kurrosetra/RCWS/Documents/Wiring pinout.xlsx

Sheet: BUTTON
from BATTERY
A | +24V BATT IN
B | +24V BATT IN
C | GND BATT IN
D | GND BATT IN
to PANEL
A | +24V OUT
B | +24V OUT
C | +24V OUT
D | GND OUT
E | GND OUT
F | GND OUT
G | COMM Out (Serial Tx)

Sheet: PANEL
from BUTTON |  | to Motor Driver
A | +24V IN | A | +24V OUT
B | +24V IN | B | +24V OUT
C | +24V IN | C | CAN High
D | GND IN | D | CAN Low
E | GND IN | E | Video+
F | GND IN | F | Video-
G | COMM In (Serial Rx) | G | +24V OUT
 |  | H | GND OUT
to Monitor & Joystick |  | I | GND OUT
1 | - | J | GND OUT
2 | - | K | +24V OUT
3 | - | L | -
4 | - | M | -
5 | - | N | GND OUT
6 | +24V OUT
7 | CAN HIGH (Joystick)
8 | CAN LOW (Joystick)
9 | GND OUT

Sheet: SLIP RING
Slip Ring |  | Panel | Motor Driver
Besar | Merah | A
 | Hitam | J
 | Hijau | B
 | Kuning | I
Kecil 1 | Merah | K
 | Hitam | N
 | Hijau | C
 | Kuning | D
 | Biru | G
 | Putih | H
Kecil 2 | Merah | -
 | Hitam | -
 | Hijau | -
 | Kuning | -
 | Biru | F
 | Putih | E
Kecil (lepas) | Merah | K
 | Hitam | N

Sheet: MOTOR_DRIVER
from Panel |  | to Optronik
A | +24V PAN | A | +24V Out
B | +24V TILT | B | GND Out
C | CAN High | C | CAN High
D | CAN Low | D | CAN Low
E | Video+ | E | Video +
F | Video- | F | Video -
G | +24V In | G | IMU Tx
H | GND In
I | GND TILT | to Trigger
J | GND PAN | 1 | TRIGGER 1
K | +24V In | 2 | TRIGGER 1
L | - | 3 | TRIGGER 1
M | - | 4 | TRIGGER 2
N | GND In | 5 | TRIGGER 2
 |  | 6 | TRIGGER 2

Sheet: OPTRONIK
to Optronik
A | +24V Out
B | GND Out
C | CAN High
D | CAN Low
E | Video +
F | Video -
G | IMU Tx

Sheet: PANEL-old
from BUTTON |  | to Motor Driver
A | +24V IN | A | +24V OUT
B | +24V IN | B | +24V OUT
C | +24V IN | C | Tx_A_Out
D | GND IN | D | Tx_B_Out
E | GND IN | E | Video+
F | GND IN | F | Video-
G | COMM In (Serial Rx) | G | Rx_A_In
 |  | H | Rx_B_In
to Monitor & Joystick |  | I | GND OUT
A | +12V OUT (Monitor) | J | GND OUT
B | +12V OUT (Joystick) | K | +24V OUT
C | CAN LOW (Joystick) | L | -
D | GND OUT (Monitor) | M | -
E | CAN HIGH (Joystick) | N | GND OUT
F | GND OUT (Joystick)
G | -

Sheet: MOTOR_DRIVER-old
from Panel |  | to Optronik
A | +24V PAN | A | +24V Out
B | +24V TILT | B | GND Out
C | Tx_A_Out | C | CAN High
D | Tx_B_Out | D | CAN Low
E | Video+ | E | Video +
F | Video- | F | Video -
G | Rx_A_In | G | IMU Tx
H | Rx_B_In
I | GND TILT | to Trigger
J | GND PAN | 1 | Motor OUT 4
K | +24V In | 2 | Motor OUT 3
L | - | 3 | -
M | - | 4 | Motor OUT 2
N | GND In | 5 | Motor OUT 1
