kurrosetra/RCWS/(list of files, drawings)

Other design files:
Boards/Optronik/optronik.PcbDoc
