kurrosetra/RCWS/Boards/Panel/panel.brd

## EAGLE design Boards/Panel/panel.brd (2018-04-27)

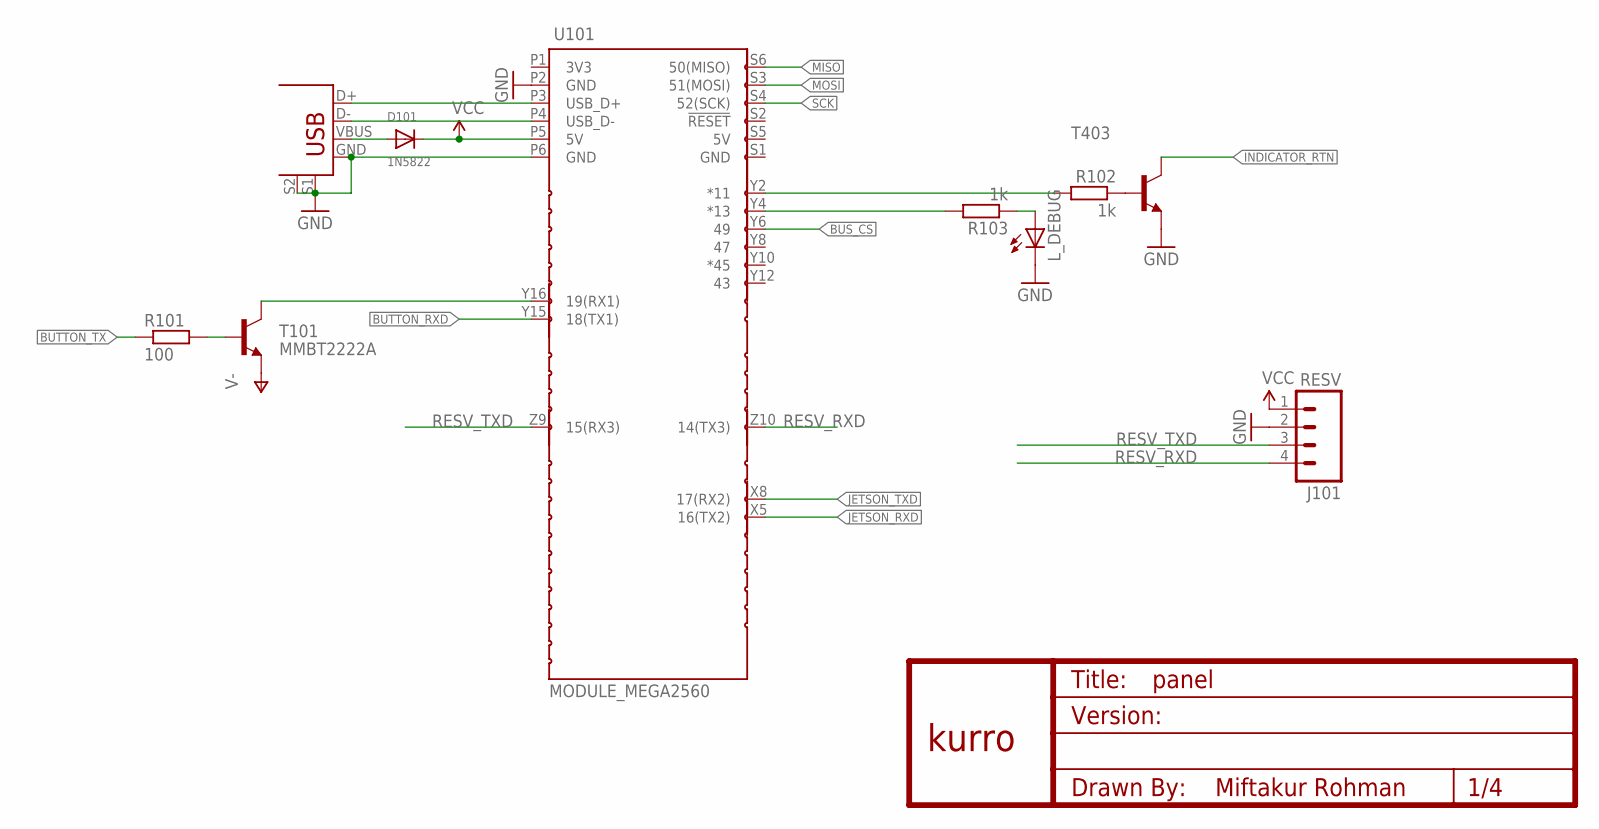
[picture p1: schematic panel.sch, sheet 1, MAIN]

Parts:
D101: 1N5822; SMADIODE
J101: RESV; XH-4-RA
L_DEBUG: LED5MM
R101: 100; R0603
R102, R103: 1k; R0603
T101: MMBT2222A; SOT23
T403: MMBT2222ALT1-NPN-SOT23-BEC; SOT23-BEC
U101: MODULE_MEGA2560; MOD_MEGA_LAYOUT
U$1: KURRO_FOOTPRINT; KURRO-LOGO
U$2: USB+SHIELD; USB-B-PTH
U$3: MOD_MEGA_LAYOUT_SERIAL1
U$4: MOD_MEGA_LAYOUT_SERIAL2
U$5: MOD_MEGA_LAYOUT_SERIAL3
U$6: MOD_MEGA_LAYOUT_ICSP
U$7: MOD_MEGA_LAYOUT_Y_EVEN

Connections:
BUS_CS: U$7.Y6 (49); also elsewhere on the board
BUTTON_RXD: U$3.Y15 (18(TX1))
BUTTON_TX: R101.1; also elsewhere on the board
BUTTON_TXD: T101.3 (C), U$3.Y16 (19(RX1))
GND: J101.2, L_DEBUG.K (C), T403.E, U101.P2 (GND), U101.P6 (GND), U$2.GND, U$2.S1, U$2.S2; also elsewhere on the board
INDICATOR_RTN: T403.C; also elsewhere on the board
JETSON_RXD: U$4.X5 (16(TX2)); also elsewhere on the board
JETSON_TXD: U$4.X8 (17(RX2)); also elsewhere on the board
MISO: U$6.S6 (50(MISO)); also elsewhere on the board
MOSI: U$6.S3 (51(MOSI)); also elsewhere on the board
unnamed: R102.1, T403.B
unnamed: U101.P3 (USB_D+), U$2.D+
unnamed: U101.P4 (USB_D-), U$2.D-
unnamed: D101.A, U$2.VBUS
unnamed: R102.2, U$7.Y2 (*11)
unnamed: R101.2, T101.1 (B)
unnamed: L_DEBUG.A, R103.1
unnamed: R103.2, U$7.Y4 (*13)
RESV_RXD: J101.4, U$5.Z10 (14(TX3))
RESV_TXD: J101.3, U$5.Z9 (15(RX3))
SCK: U$6.S4 (52(SCK)); also elsewhere on the board
V-: T101.2 (E); also elsewhere on the board
VCC: D101.C, J101.1, U101.P5 (5V); also elsewhere on the board

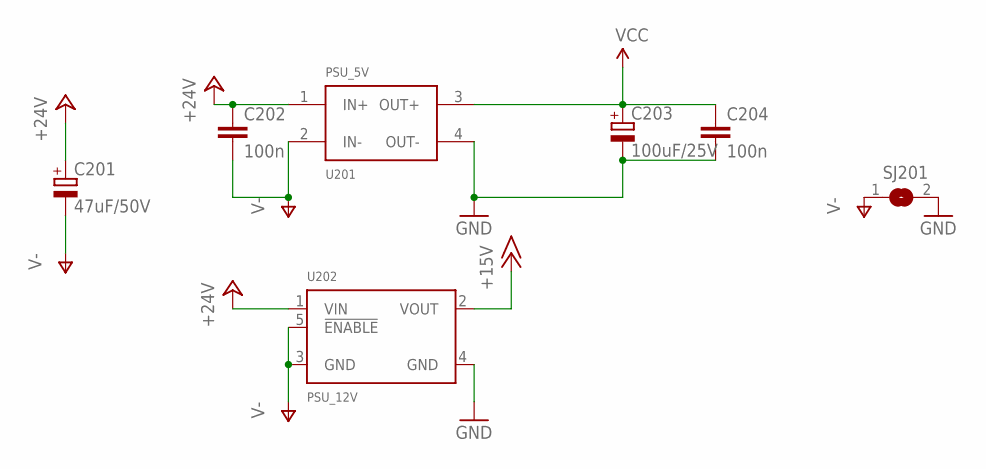
[picture p2: schematic panel.sch, sheet 2, PSU]

Parts:
C201: 47uF/50V; E2,5-7
C202, C204: 100n; C0603
C203: 100uF/25V; E2,5-7
SJ201: SJS
U201: PSU_5V; MP1584_MIN
U202: PSU_12V; MOD_LM2596

Connections:
+15V: U202.2 (VOUT); also elsewhere on the board
+24V: C201.+, C202.1, U201.1 (IN+), U202.1 (VIN); also elsewhere on the board
GND: C203.-, C204.2, SJ201.2, U201.4 (OUT-), U202.4 (GND); also elsewhere on the board
V-: C201.-, C202.2, SJ201.1, U201.2 (IN-), U202.3 (GND), U202.5 (!ENABLE); also elsewhere on the board
VCC: C203.+, C204.1, U201.3 (OUT+); also elsewhere on the board

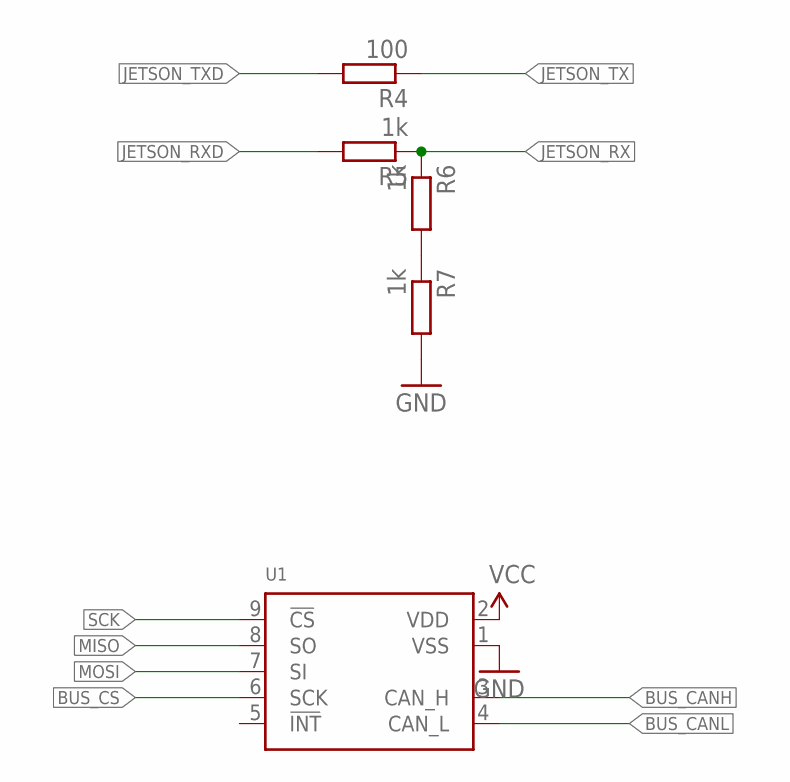
[picture p3: schematic panel.sch, sheet 3, COMM]

Parts:
R4: 100; R0603
R5, R6, R7: 1k; R0603
U1: MOD_MCP2515_NH; MCP2515_CAN2

Connections:
BUS_CANH: U1.3 (CAN_H); also elsewhere on the board
BUS_CANL: U1.4 (CAN_L); also elsewhere on the board
BUS_CS: U1.6 (SCK); also elsewhere on the board
GND: R7.2, U1.1 (VSS); also elsewhere on the board
JETSON_RX: R5.1, R6.1; also elsewhere on the board
JETSON_RXD: R5.2; also elsewhere on the board
JETSON_TX: R4.1; also elsewhere on the board
JETSON_TXD: R4.2; also elsewhere on the board
MISO: U1.8 (SO); also elsewhere on the board
MOSI: U1.7 (SI); also elsewhere on the board
unnamed: R6.2, R7.1
SCK: U1.9 (!CS); also elsewhere on the board
VCC: U1.2 (VDD); also elsewhere on the board

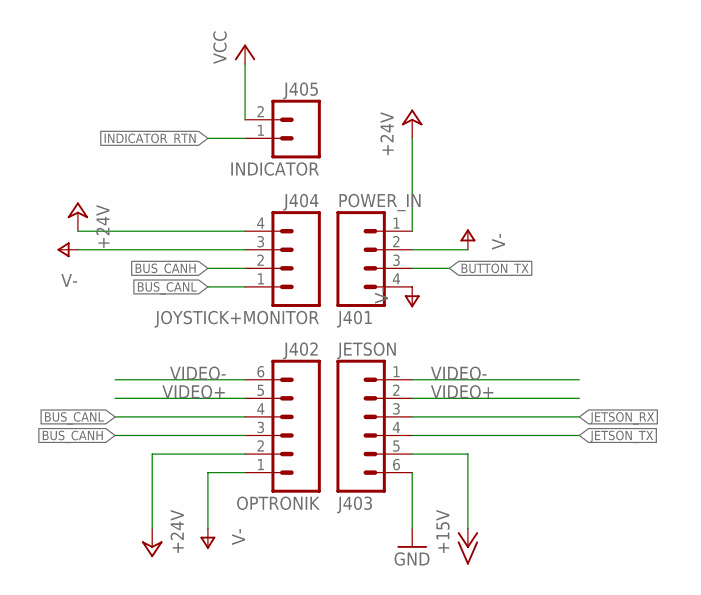
[picture p4: schematic panel.sch, sheet 4, CONNECTOR]

Parts:
J401: POWER_IN; XH-4-RA
J402: OPTRONIK; XH-6-RA
J403: JETSON; XH-6-RA
J404: JOYSTICK+MONITOR; XH-4-RA
J405: INDICATOR; XH-2-RA

Connections:
+15V: J403.5; also elsewhere on the board
+24V: J401.1, J402.2, J404.4; also elsewhere on the board
BUS_CANH: J402.3, J404.2; also elsewhere on the board
BUS_CANL: J402.4, J404.1; also elsewhere on the board
BUTTON_TX: J401.3; also elsewhere on the board
GND: J403.6; also elsewhere on the board
INDICATOR_RTN: J405.1; also elsewhere on the board
JETSON_RX: J403.3; also elsewhere on the board
JETSON_TX: J403.4; also elsewhere on the board
V-: J401.2, J401.4, J402.1, J404.3; also elsewhere on the board
VCC: J405.2; also elsewhere on the board
VIDEO+: J402.5, J403.2
VIDEO-: J402.6, J403.1

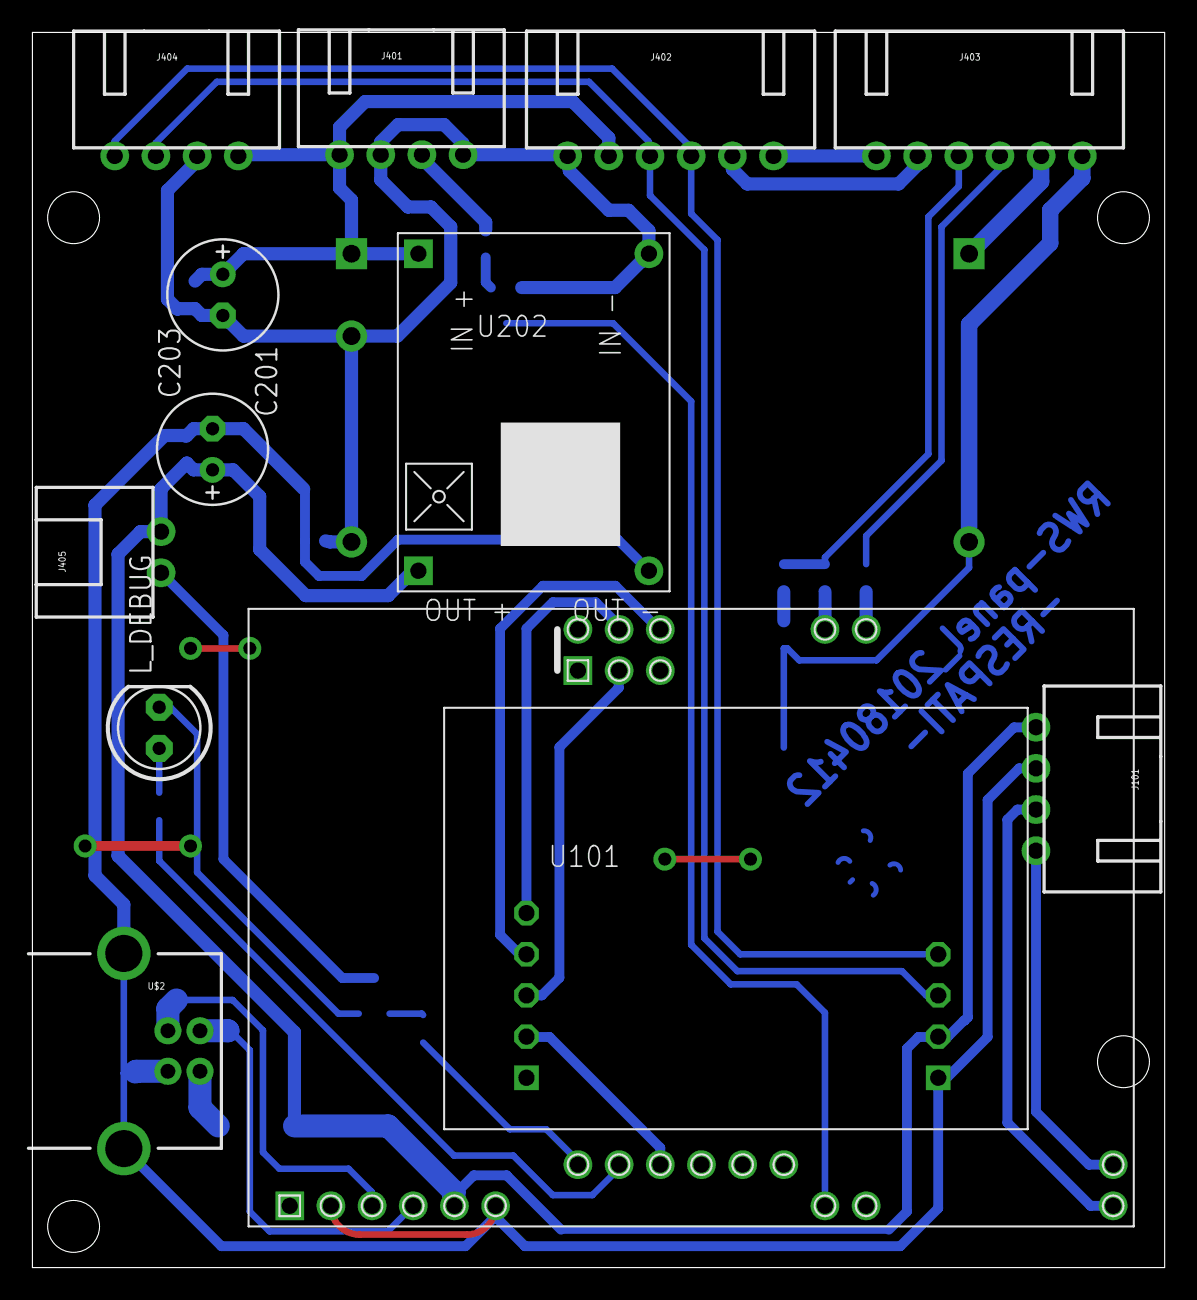
[picture p5: board panel.brd from above]

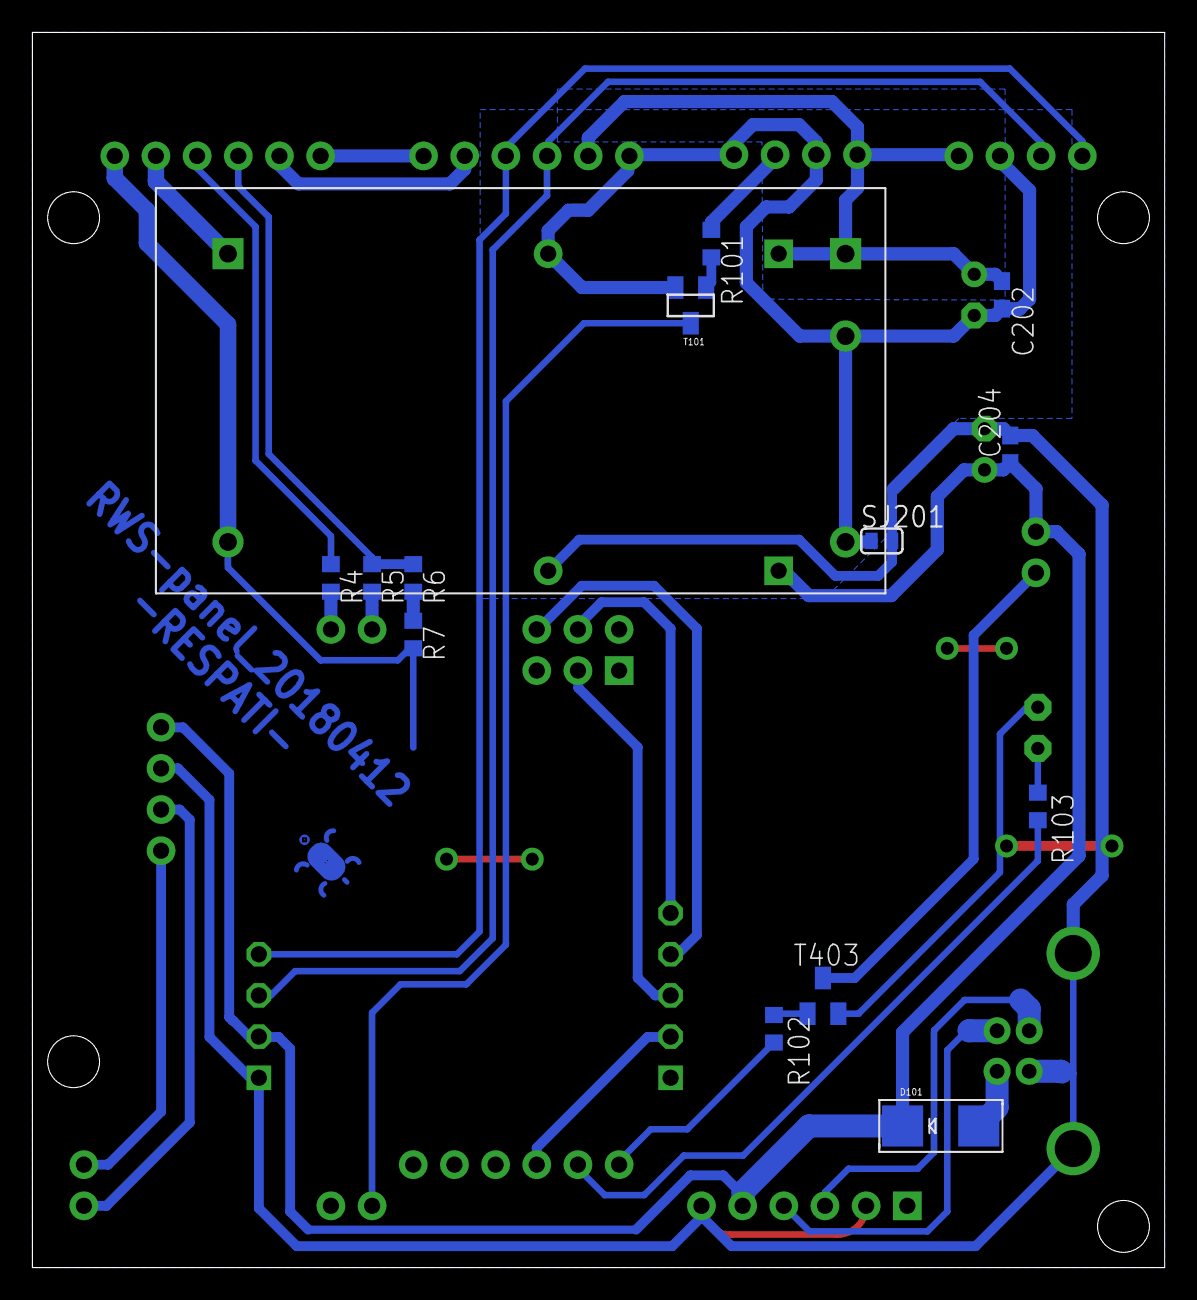
[picture p6: board panel.brd from below]

Board: 2 copper layers, 69.8 x 76.2 mm, 33 parts (13 on the bottom side), 31 nets.
