kurrosetra/RCWS/Boards/motorControl/motorController.brd

## EAGLE design Boards/motorControl/motorController.brd (2018-04-27)

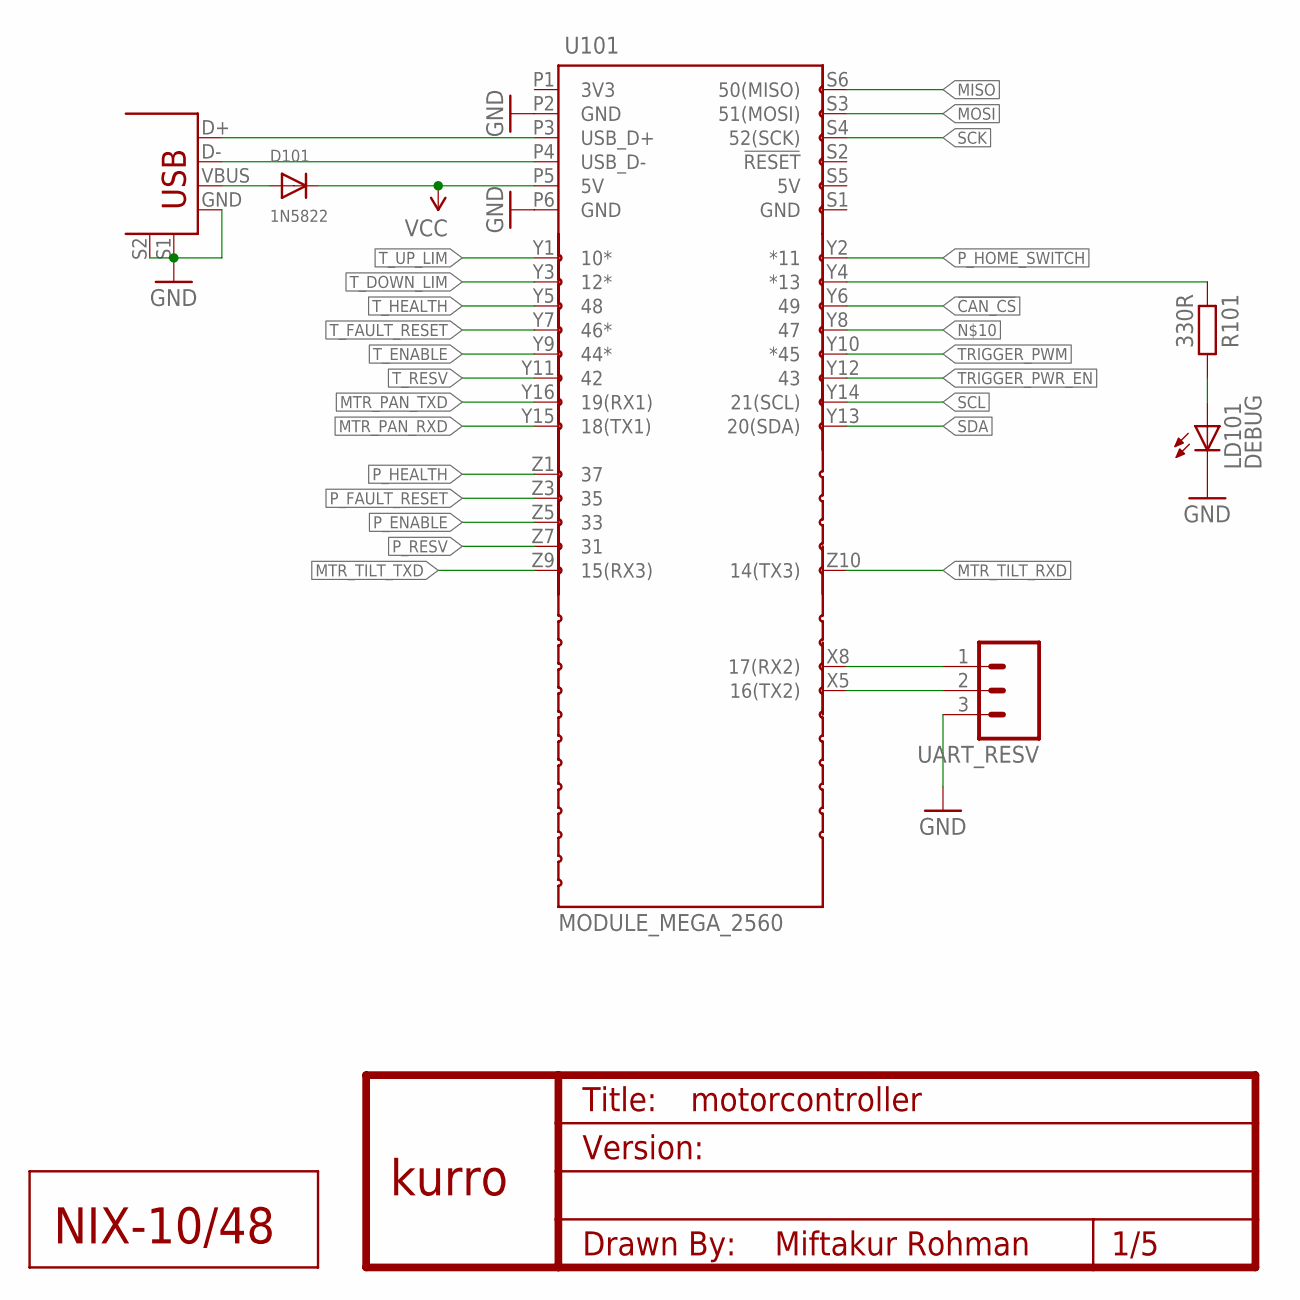
[picture p7: schematic motorController.sch, sheet 1, MAIN]

Parts:
D101: 1N5822; SMADIODE
J101: USB+SHIELD; USB-B-PTH
LD101: DEBUG; LED5MM
R101: 330R; R0603
U101: MODULE_MEGA_2560; MOD_MEGA_LAYOUT
U$1: KURRO_FOOTPRINT; KURRO-LOGO
U$2: NIX; NIX-XX/XXX
U$3: MOD_MEGA_LAYOUT_ICSP
U$4: MOD_MEGA_LAYOUT_SERIAL1
U$5: MOD_MEGA_LAYOUT_SERIAL2
U$6: MOD_MEGA_LAYOUT_SERIAL3
U$7: MOD_MEGA_LAYOUT_Y_EVEN
U$8: MOD_MEGA_LAYOUT_Y_ODD
U$9: MOD_MEGA_LAYOUT_Z_ODD
U$10: MOD_MEGA_LAYOUT_I2C
UART_RESV: M03LOCK; 1X03_LOCK

Connections:
!CAN_CS: U$7.Y6 (49); also elsewhere on the board
GND: J101.GND, J101.S1, J101.S2, LD101.K (C), U101.P2 (GND), U101.P6 (GND), UART_RESV.3; also elsewhere on the board
MISO: U$3.S6 (50(MISO)); also elsewhere on the board
MOSI: U$3.S3 (51(MOSI)); also elsewhere on the board
MTR_PAN_RXD: U$4.Y15 (18(TX1)); also elsewhere on the board
MTR_PAN_TXD: U$4.Y16 (19(RX1)); also elsewhere on the board
MTR_TILT_RXD: U$6.Z10 (14(TX3)); also elsewhere on the board
MTR_TILT_TXD: U$6.Z9 (15(RX3)); also elsewhere on the board
unnamed: LD101.A, R101.2
unnamed: J101.D+, U101.P3 (USB_D+)
unnamed: R101.1, U$7.Y4 (*13)
unnamed: J101.D-, U101.P4 (USB_D-)
unnamed: D101.A, J101.VBUS
P_ENABLE: U$9.Z5 (33); also elsewhere on the board
P_FAULT_RESET: U$9.Z3 (35); also elsewhere on the board
P_HEALTH: U$9.Z1 (37); also elsewhere on the board
P_HOME_SWITCH: U$7.Y2 (*11); also elsewhere on the board
P_RESV: U$9.Z7 (31); also elsewhere on the board
RXD2: U$5.X8 (17(RX2)), UART_RESV.1
SCK: U$3.S4 (52(SCK)); also elsewhere on the board
SCL: U$10.Y14 (21(SCL))
SDA: U$10.Y13 (20(SDA))
TRIGGER_PWM: U$7.Y10 (*45); also elsewhere on the board
TRIGGER_PWR_EN: U$7.Y12 (43); also elsewhere on the board
TXD2: U$5.X5 (16(TX2)), UART_RESV.2
T_DOWN_LIM: U$8.Y3 (12*); also elsewhere on the board
T_ENABLE: U$8.Y9 (44*); also elsewhere on the board
T_FAULT_RESET: U$8.Y7 (46*); also elsewhere on the board
T_HEALTH: U$8.Y5 (48); also elsewhere on the board
T_RESV: U$8.Y11 (42); also elsewhere on the board
T_UP_LIM: U$8.Y1 (10*); also elsewhere on the board
VCC: D101.C, U101.P5 (5V); also elsewhere on the board

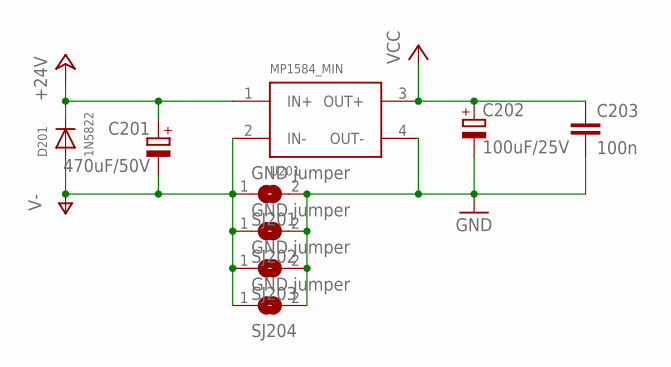
[picture p8: schematic motorController.sch, sheet 2, PSU]

Parts:
C201: 470uF/50V; E5-10,5
C202: 100uF/25V; E5-10,5
C203: 100n; C0603
D201: 1N5822; SMADIODE
SJ201, SJ202, SJ203, SJ204: GND jumper; SJS
U201: MP1584_MIN

Connections:
+24V: C201.+, D201.C, U201.1 (IN+); also elsewhere on the board
GND: C202.-, C203.2, SJ201.2, SJ202.2, SJ203.2, SJ204.2, U201.4 (OUT-); also elsewhere on the board
V-: C201.-, D201.A, SJ201.1, SJ202.1, SJ203.1, SJ204.1, U201.2 (IN-); also elsewhere on the board
VCC: C202.+, C203.1, U201.3 (OUT+); also elsewhere on the board

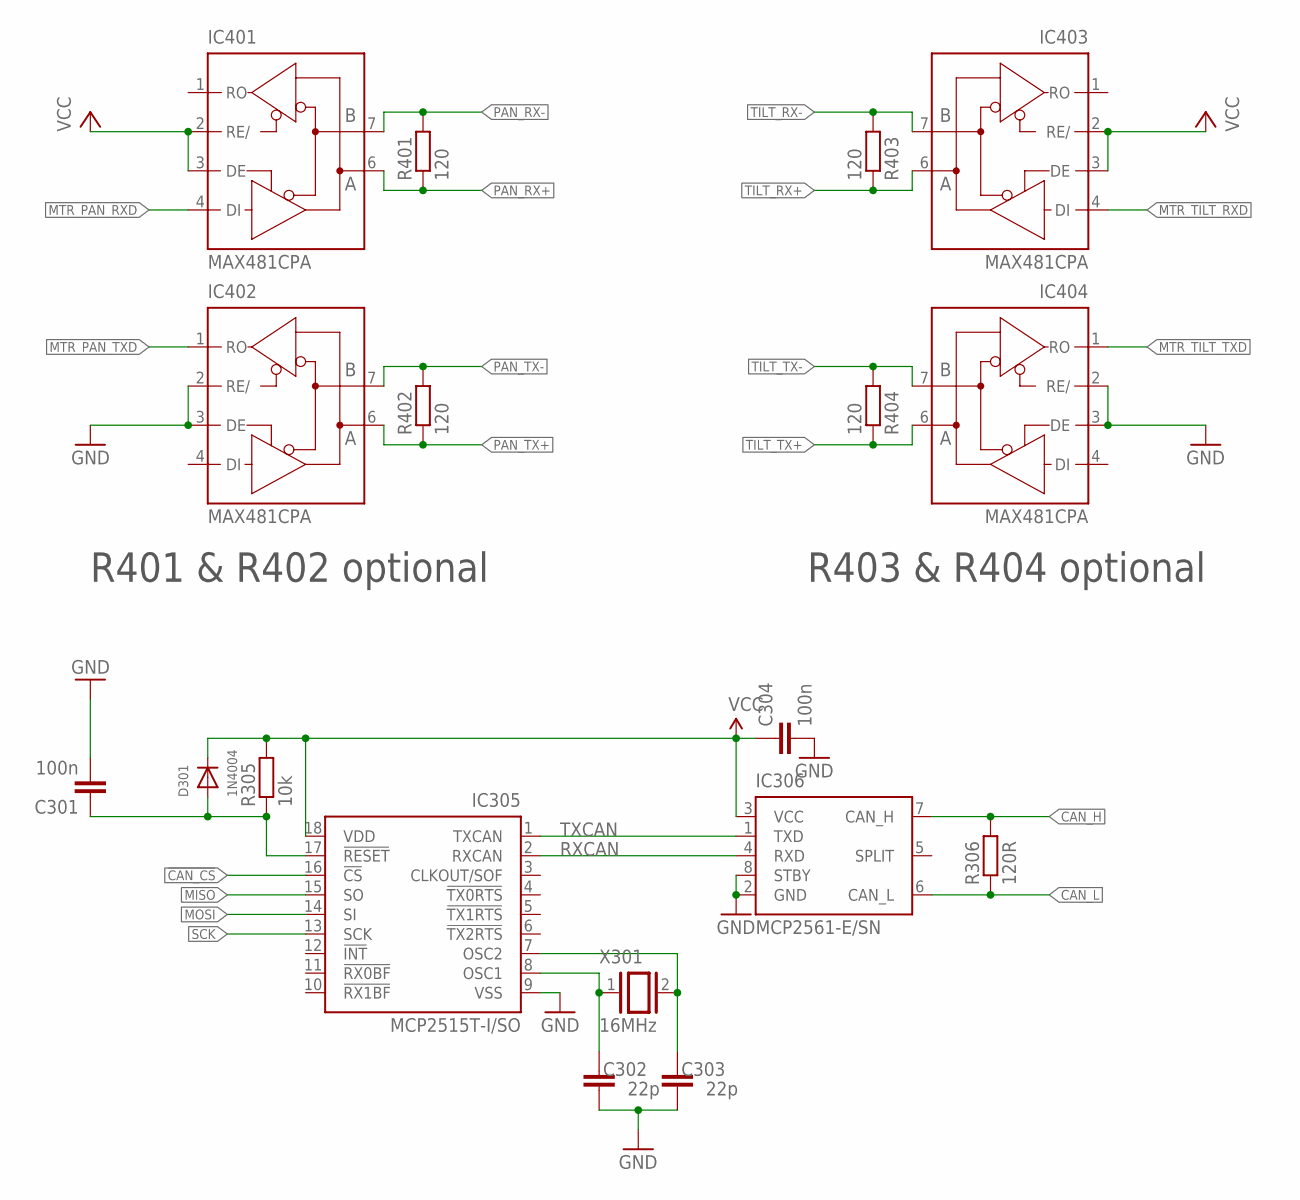
[picture p9: schematic motorController.sch, sheet 3, COMM]

Parts:
C301, C304: 100n; C0603
C302, C303: 22p; C0603
D301: 1N4004; SOD-323F
IC305: MCP2515T-I/SO; SO-18
IC306: MCP2561-E/SN; SOIC-8
IC401, IC402, IC403, IC404: MAX481CPA; DIL08
R305: 10k; R0603
R306: 120R; R0603
R401, R402, R403, R404: 120; R0603
X301: 16MHz; QS

Connections:
!CAN_CS: IC305.16 (!CS); also elsewhere on the board
CAN_H: IC306.7 (CAN_H), R306.2; also elsewhere on the board
CAN_L: IC306.6 (CAN_L), R306.1; also elsewhere on the board
GND: C301.2, C302.1, C303.1, C304.2, IC305.9 (VSS), IC306.2 (GND), IC306.8 (STBY), IC401.5 (GND), IC402.2 (RE/), IC402.3 (DE), IC402.5 (GND), IC403.5 (GND), IC404.2 (RE/), IC404.3 (DE), IC404.5 (GND); also elsewhere on the board
MISO: IC305.15 (SO); also elsewhere on the board
MOSI: IC305.14 (SI); also elsewhere on the board
MTR_PAN_RXD: IC401.4 (DI); also elsewhere on the board
MTR_PAN_TXD: IC402.1 (RO); also elsewhere on the board
MTR_TILT_RXD: IC403.4 (DI); also elsewhere on the board
MTR_TILT_TXD: IC404.1 (RO); also elsewhere on the board
unnamed: C301.1, D301.A, IC305.17 (!RESET), R305.1
unnamed: C302.2, IC305.8 (OSC1), X301.1
unnamed: C303.2, IC305.7 (OSC2), X301.2
PAN_RX+: IC401.6 (A), R401.1; also elsewhere on the board
PAN_RX-: IC401.7 (B), R401.2; also elsewhere on the board
PAN_TX+: IC402.6 (A), R402.1; also elsewhere on the board
PAN_TX-: IC402.7 (B), R402.2; also elsewhere on the board
RXCAN: IC305.2 (RXCAN), IC306.4 (RXD)
SCK: IC305.13 (SCK); also elsewhere on the board
TILT_RX+: IC403.6 (A), R403.1; also elsewhere on the board
TILT_RX-: IC403.7 (B), R403.2; also elsewhere on the board
TILT_TX+: IC404.6 (A), R404.1; also elsewhere on the board
TILT_TX-: IC404.7 (B), R404.2; also elsewhere on the board
TXCAN: IC305.1 (TXCAN), IC306.1 (TXD)
VCC: C304.1, D301.C, IC305.18 (VDD), IC306.3 (VCC), IC401.2 (RE/), IC401.3 (DE), IC401.8 (VCC), IC402.8 (VCC), IC403.2 (RE/), IC403.3 (DE), IC403.8 (VCC), IC404.8 (VCC), R305.2; also elsewhere on the board

Notes on the sheet:
R401 & R402 optional
R403 & R404 optional

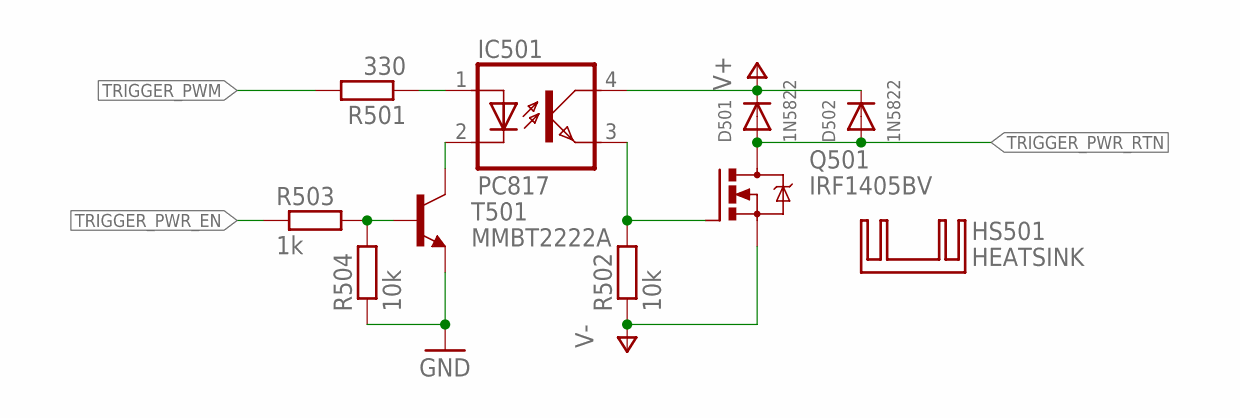
[picture p10: schematic motorController.sch, sheet 4, TRIGGER]

Parts:
D501, D502: 1N5822; SMADIODE
HS501: HEATSINK; BV_150X105
IC501: PC817; DIL04
Q501: IRF1405BV; TO220BV
R501: 330; R0603
R502, R504: 10k; R0603
R503: 1k; R0603
T501: MMBT2222A; SOT23

Connections:
GND: R504.1, T501.2 (E); also elsewhere on the board
unnamed: IC501.2 (C), T501.3 (C)
unnamed: R503.2, R504.2, T501.1 (B)
unnamed: IC501.1 (A), R501.1
unnamed: IC501.3 (EMIT), Q501.G, R502.2
TRIGGER_PWM: R501.2; also elsewhere on the board
TRIGGER_PWR_EN: R503.1; also elsewhere on the board
TRIGGER_PWR_RTN: D501.A, D502.A, Q501.D; also elsewhere on the board
V+: D501.C, D502.C, IC501.4 (COL); also elsewhere on the board
V-: Q501.S, R502.1; also elsewhere on the board

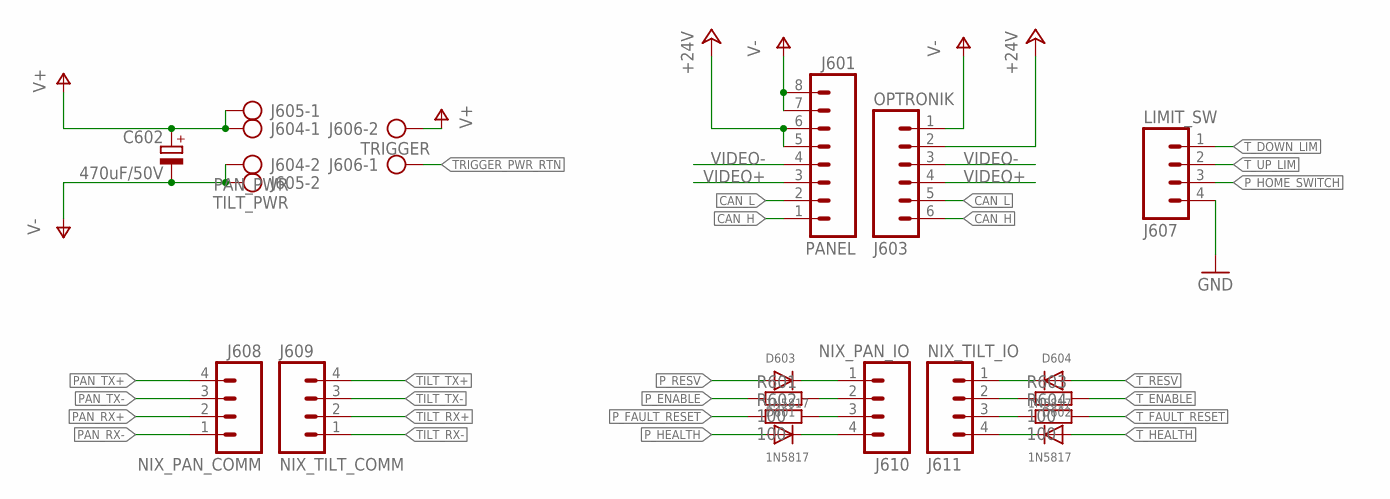
[picture p11: schematic motorController.sch, sheet 5, CONNECTOR]

Parts:
C602: 470uF/50V; E5-10,5
D601, D602, D603, D604: 1N5817; SOD-323F
J601: PANEL; XH-8-RA
J603: OPTRONIK; XH-6-RA
J604: PAN_PWR; AK200/2
J605: TILT_PWR; AK200/2
J606: TRIGGER; AK200/2
J607: LIMIT_SW; XH-4-RA
J608: NIX_PAN_COMM; XH-4-RA
J609: NIX_TILT_COMM; XH-4-RA
J610: NIX_PAN_IO; XH-4-RA
J611: NIX_TILT_IO; XH-4-RA
R601, R602, R603, R604: 100; R0603

Connections:
+24V: J601.5, J601.6, J603.2; also elsewhere on the board
CAN_H: J601.1, J603.6; also elsewhere on the board
CAN_L: J601.2, J603.5; also elsewhere on the board
GND: J607.4; also elsewhere on the board
unnamed: D603.C, J610.1
unnamed: D604.C, J611.1
unnamed: J611.2, R603.1
unnamed: J611.3, R604.1
unnamed: D602.C, J611.4
unnamed: D601.C, J610.4
unnamed: J610.2, R601.2
unnamed: J610.3, R602.2
PAN_RX+: J608.2; also elsewhere on the board
PAN_RX-: J608.1; also elsewhere on the board
PAN_TX+: J608.4; also elsewhere on the board
PAN_TX-: J608.3; also elsewhere on the board
P_ENABLE: R601.1; also elsewhere on the board
P_FAULT_RESET: R602.1; also elsewhere on the board
P_HEALTH: D601.A; also elsewhere on the board
P_HOME_SWITCH: J607.3; also elsewhere on the board
P_RESV: D603.A; also elsewhere on the board
TILT_RX+: J609.2; also elsewhere on the board
TILT_RX-: J609.1; also elsewhere on the board
TILT_TX+: J609.4; also elsewhere on the board
TILT_TX-: J609.3; also elsewhere on the board
TRIGGER_PWR_RTN: J606.1; also elsewhere on the board
T_DOWN_LIM: J607.1; also elsewhere on the board
T_ENABLE: R603.2; also elsewhere on the board
T_FAULT_RESET: R604.2; also elsewhere on the board
T_HEALTH: D602.A; also elsewhere on the board
T_RESV: D604.A; also elsewhere on the board
T_UP_LIM: J607.2; also elsewhere on the board
V+: C602.+, J604.1, J605.1, J606.2; also elsewhere on the board
V-: C602.-, J601.7, J601.8, J603.1, J604.2, J605.2; also elsewhere on the board
VIDEO+: J601.3, J603.4
VIDEO-: J601.4, J603.3

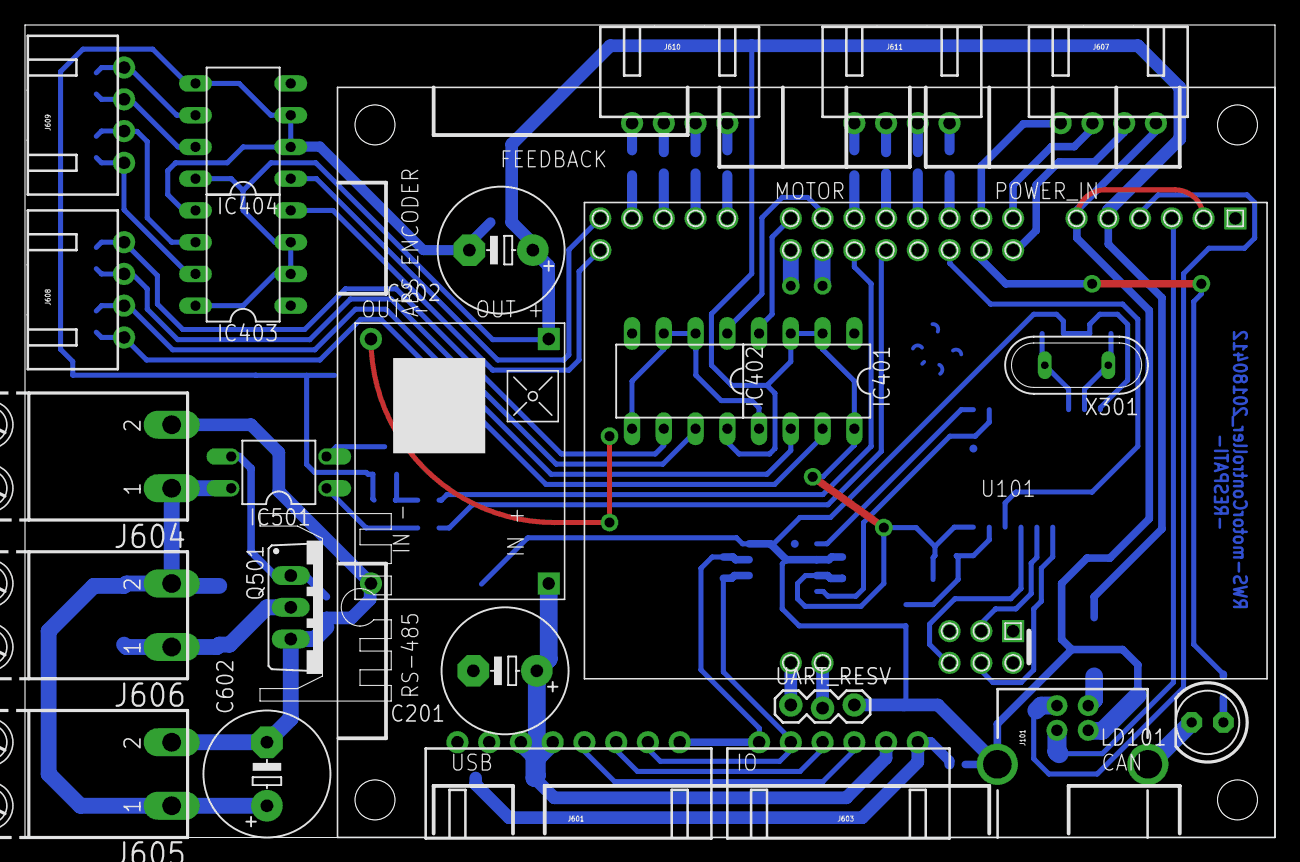
[picture p12: board motorController.brd from above]

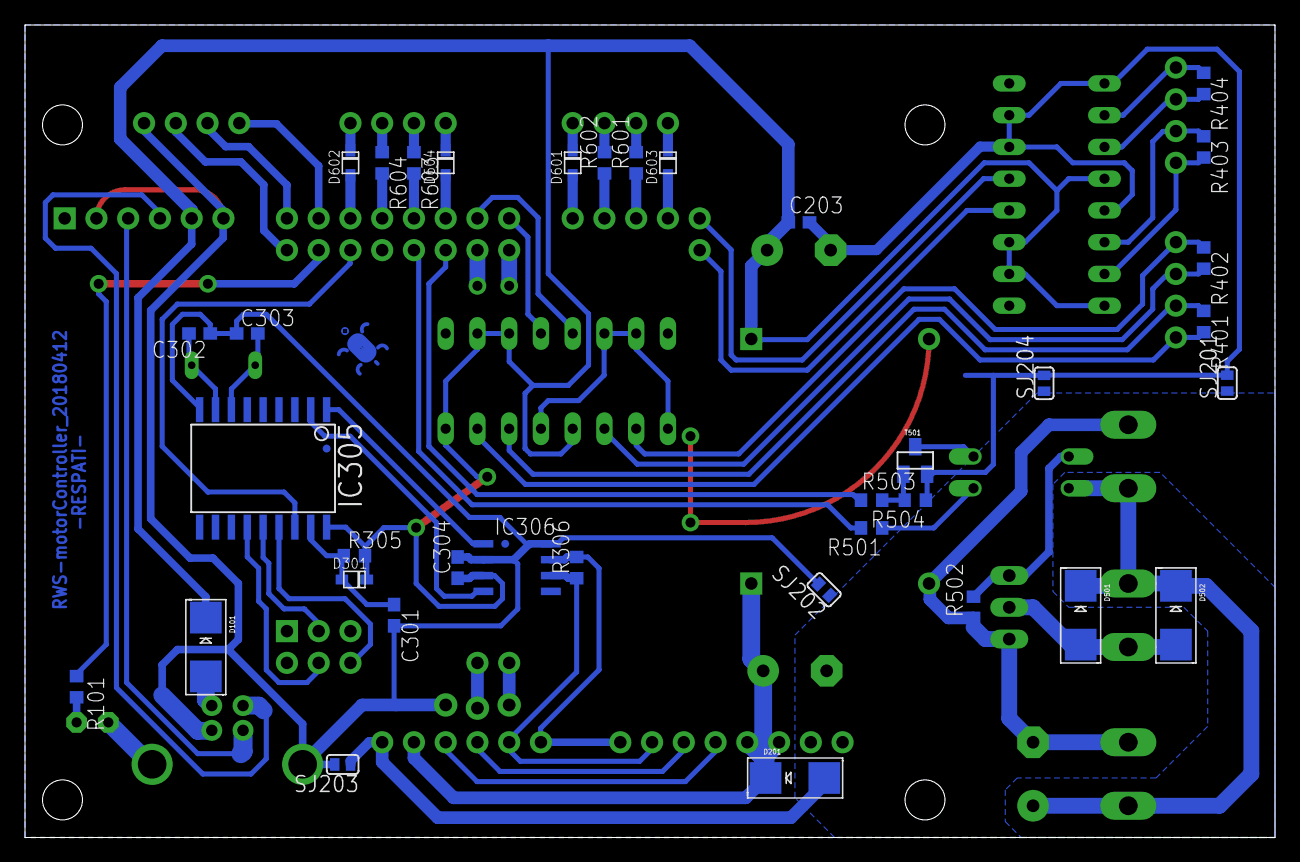
[picture p13: board motorController.brd from below]

Board: 2 copper layers, 100.0 x 65.0 mm, 72 parts (36 on the bottom side), 63 nets.
