kurrosetra/RCWS/Boards/Button/button.brd

## EAGLE design Boards/Button/button.brd (2018-02-23)

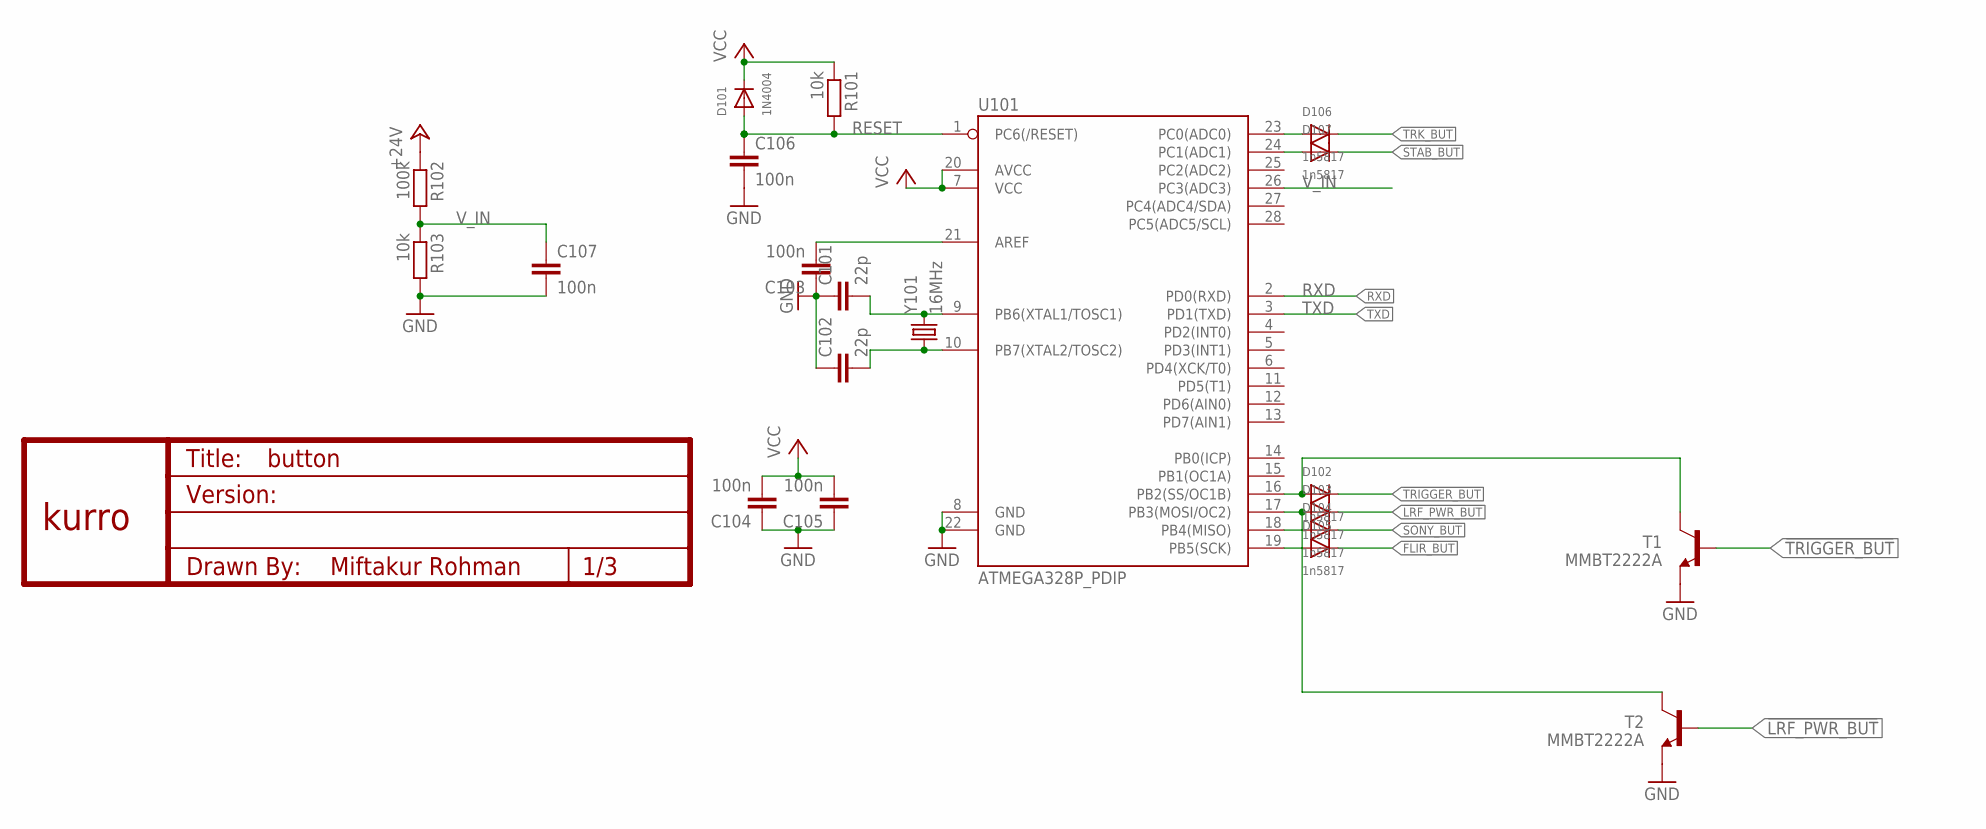
[picture p14: schematic button.sch, sheet 1, MAIN]

Parts:
C101, C102: 22p; C0603
C103, C104, C105, C106, C107: 100n; C0603
D101: 1N4004; SOD-323F
D102, D103, D104, D105, D106, D107: 1n5817; SOD-323F
R101, R103: 10k; R0603
R102: 100k; R0603
T1, T2: MMBT2222A; SOT23
U101: ATMEGA328P_PDIP; DIL28-3
U$1: KURRO_FOOTPRINT; KURRO-LOGO
Y101: 16MHz; CRYSTAL-TXC-7A2

Connections:
!LRF_PWR_BUT: D103.C, T2.1 (B); also elsewhere on the board
!TRIGGER_BUT: D102.C, T1.1 (B); also elsewhere on the board
+24V: R102.1; also elsewhere on the board
FLIR_BUT: D105.C; also elsewhere on the board
GND: C101.1, C102.1, C103.1, C104.1, C105.1, C106.2, C107.2, R103.2, T1.2 (E), T2.2 (E), U101.8 (GND), U101.22 (GND); also elsewhere on the board
unnamed: D104.A, U101.18 (PB4(MISO))
unnamed: D105.A, U101.19 (PB5(SCK))
unnamed: D103.A, T2.3 (C), U101.17 (PB3(MOSI/OC2))
unnamed: D106.A, U101.23 (PC0(ADC0))
unnamed: D107.A, U101.24 (PC1(ADC1))
unnamed: D102.A, T1.3 (C), U101.16 (PB2(SS/OC1B))
unnamed: C101.2, U101.9 (PB6(XTAL1/TOSC1)), Y101.P$2 (2)
unnamed: C102.2, U101.10 (PB7(XTAL2/TOSC2)), Y101.P$1 (1)
unnamed: C103.2, U101.21 (AREF)
RESET: C106.1, D101.A, R101.2, U101.1 (PC6(/RESET))
RXD: U101.2 (PD0(RXD))
SONY_BUT: D104.C; also elsewhere on the board
STAB_BUT: D107.C; also elsewhere on the board
TRK_BUT: D106.C; also elsewhere on the board
TXD: U101.3 (PD1(TXD)); also elsewhere on the board
VCC: C104.2, C105.2, D101.C, R101.1, U101.7 (VCC), U101.20 (AVCC); also elsewhere on the board
V_IN: C107.1, R102.2, R103.1, U101.26 (PC3(ADC3))

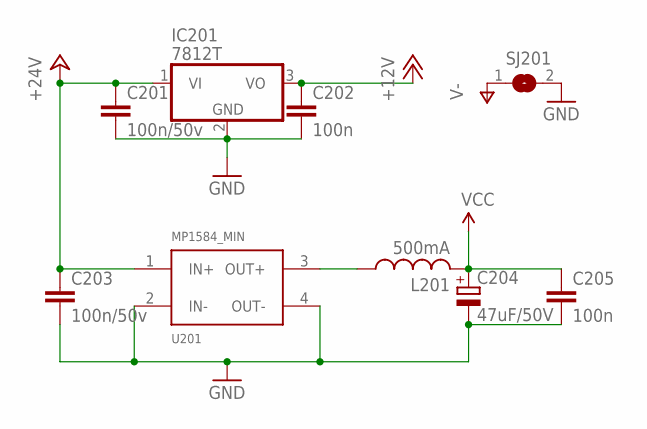
[picture p15: schematic button.sch, sheet 2, PSU]

Parts:
C201, C203: 100n/50v; C0603
C202, C205: 100n; C0603
C204: 47uF/50V; E2,5-7
IC201: 7812T; TO220H
L201: 500mA; L1812
SJ201: SJ
U201: MP1584_MIN

Connections:
+12V: C202.1, IC201.3 (VO); also elsewhere on the board
+24V: C201.1, C203.1, IC201.1 (VI), U201.1 (IN+); also elsewhere on the board
GND: C201.2, C202.2, C203.2, C204.-, C205.2, IC201.2 (GND), SJ201.2, U201.2 (IN-), U201.4 (OUT-); also elsewhere on the board
unnamed: L201.1, U201.3 (OUT+)
V-: SJ201.1; also elsewhere on the board
VCC: C204.+, C205.1, L201.2; also elsewhere on the board
