kurrosetra/RCWS/Boards/Button/button.brd

## EAGLE design Boards/Button/button.brd (continued)

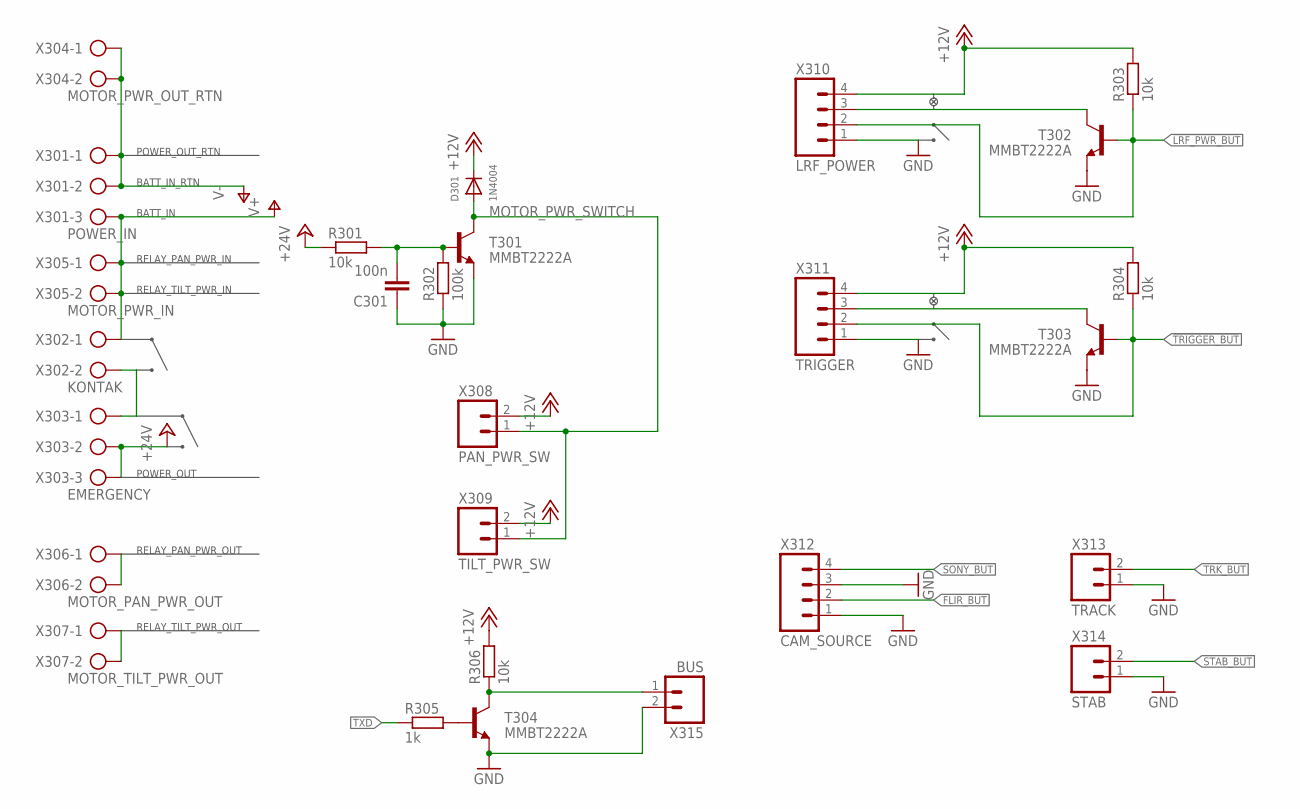
[picture p16: schematic button.sch, sheet 3, CONNECTOR]

Parts:
C301: 100n; C0603
D301: 1N4004; SOD-323F
R301, R303, R304, R306: 10k; R0603
R302: 100k; R0603
R305: 1k; R0603
T301, T302, T303, T304: MMBT2222A; SOT23
X301: POWER_IN; AK300/3
X302: KONTAK; AK300/2
X303: EMERGENCY; AK300/3
X304: MOTOR_PWR_OUT_RTN; AK300/2
X305: MOTOR_PWR_IN; AK300/2
X306: MOTOR_PAN_PWR_OUT; AK300/2
X307: MOTOR_TILT_PWR_OUT; AK300/2
X308: PAN_PWR_SW; JST-2-PTH-VERT
X309: TILT_PWR_SW; JST-2-PTH-VERT
X310: LRF_POWER; JST-4-PTH-VERT
X311: TRIGGER; JST-4-PTH-VERT
X312: CAM_SOURCE; JST-4-PTH-VERT
X313: TRACK; JST-2-PTH-VERT
X314: STAB; JST-2-PTH-VERT
X315: BUS; JST-2-PTH-VERT

Connections:
!LRF_PWR_BUT: R303.1, T302.1 (B), X310.2; also elsewhere on the board
!TRIGGER_BUT: R304.1, T303.1 (B), X311.2; also elsewhere on the board
+12V: D301.C, R303.2, R304.2, R306.2, X308.2, X309.2, X310.4, X311.4; also elsewhere on the board
+24V: R301.1, X303.2, X303.3; also elsewhere on the board
BUS1: R306.1, T304.3 (C), X315.1
FLIR_BUT: X312.2; also elsewhere on the board
GND: C301.1, R302.1, T301.2 (E), T302.2 (E), T303.2 (E), T304.2 (E), X310.1, X311.1, X312.1, X312.3, X313.1, X314.1, X315.2; also elsewhere on the board
KONTAK_EMER_JUNCTION: X302.2, X303.1
MOTOR_PWR_SWITCH: D301.A, T301.3 (C), X308.1, X309.1
unnamed: C301.2, R301.2, R302.2, T301.1 (B)
unnamed: X306.1, X306.2
unnamed: X307.1, X307.2
unnamed: T303.3 (C), X311.3
unnamed: T302.3 (C), X310.3
unnamed: R305.2, T304.1 (B)
SONY_BUT: X312.4; also elsewhere on the board
STAB_BUT: X314.2; also elsewhere on the board
TRK_BUT: X313.2; also elsewhere on the board
TXD: R305.1; also elsewhere on the board
V+: X301.3, X302.1, X305.1, X305.2
V-: X301.1, X301.2, X304.1, X304.2; also elsewhere on the board

Notes on the sheet:
RELAY_PAN_PWR_IN
RELAY_TILT_PWR_IN
RELAY_PAN_PWR_OUT
RELAY_TILT_PWR_OUT
POWER_OUT_RTN
POWER_OUT
BATT_IN
BATT_IN_RTN

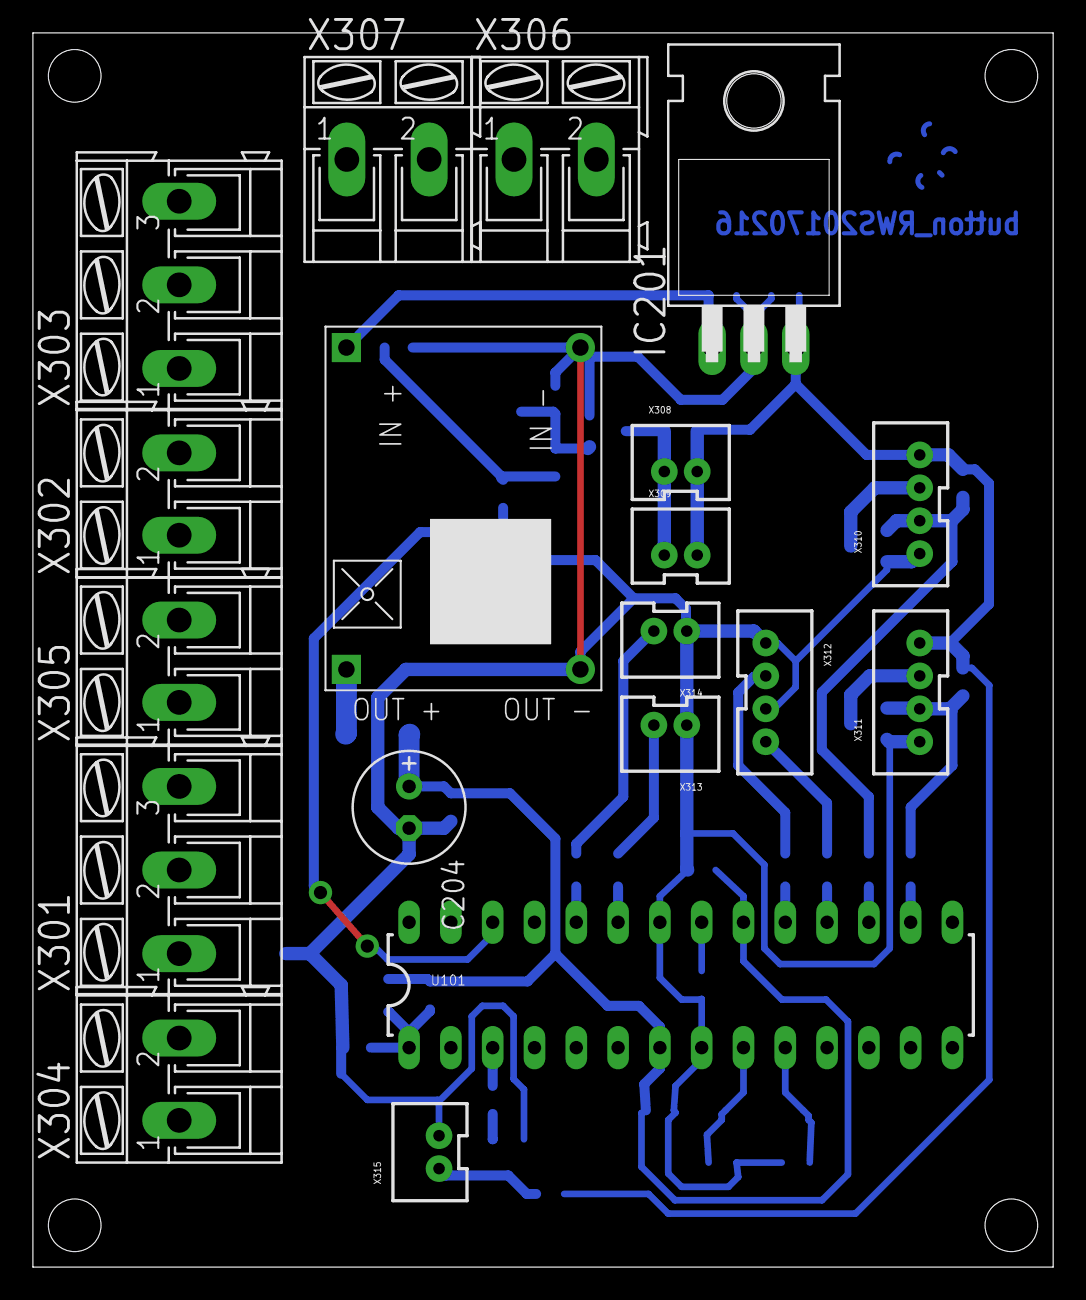
[picture p17: board button.brd from above]

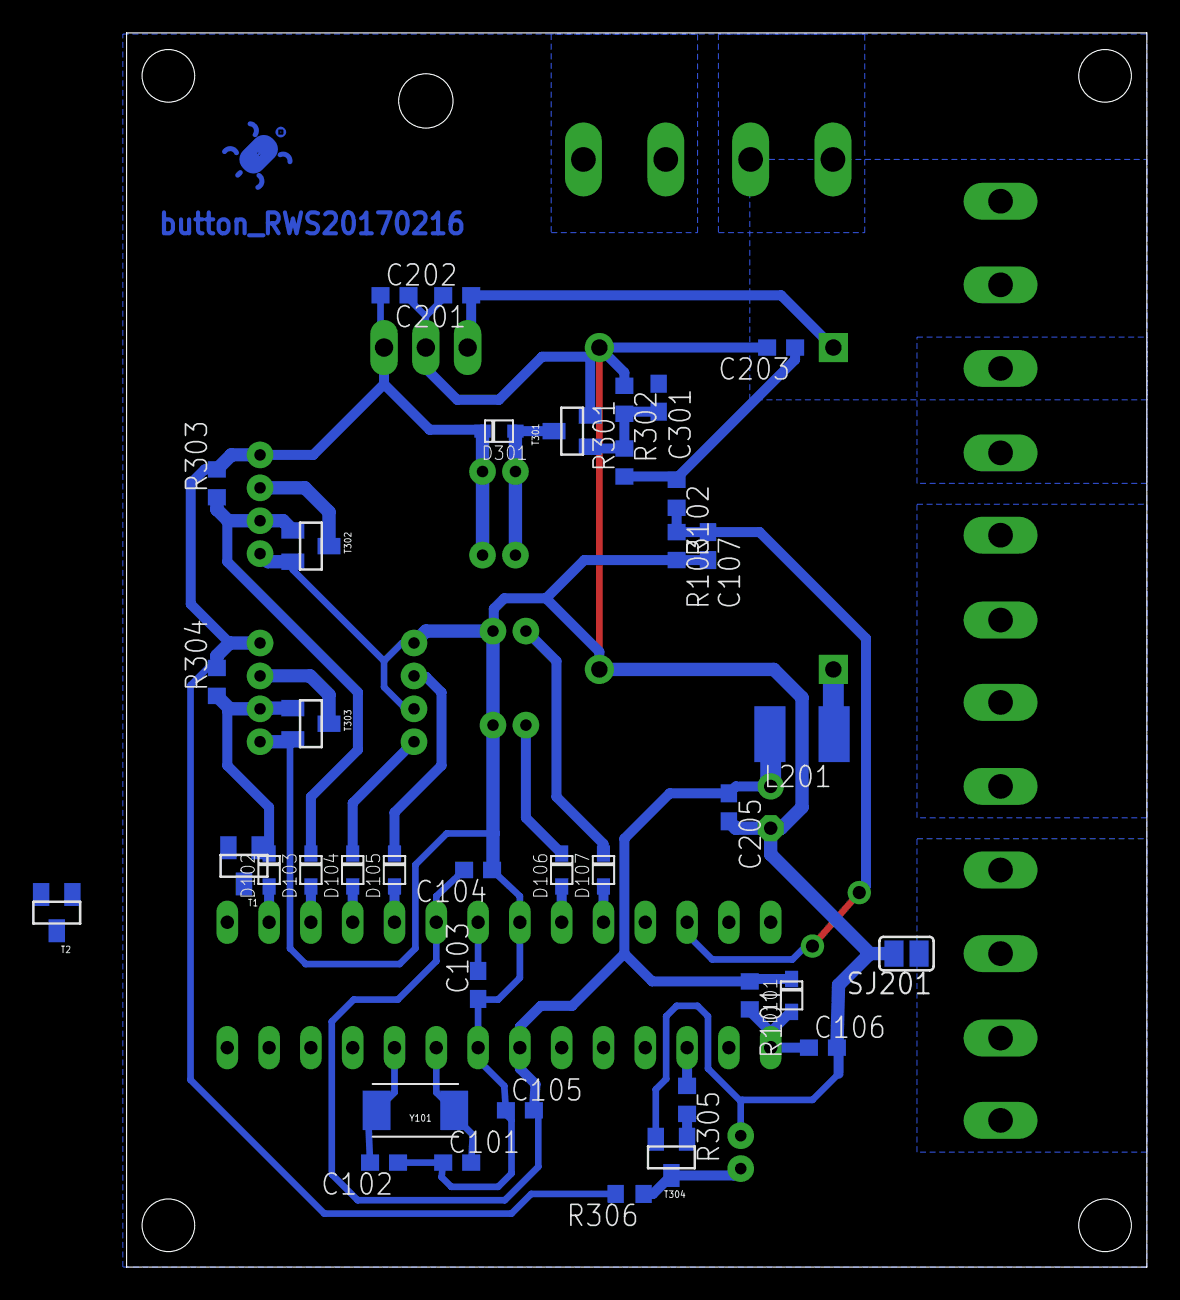
[picture p18: board button.brd from below]

Board: 2 copper layers, 62.0 x 75.0 mm, 58 parts (38 on the bottom side), 34 nets.
