kurrosetra/RCWS/(commit log)

2018-02-23 add documentation
    - add canID
    - add wiring diagram
    - add wiring pinout
    [Wiring pinout.xlsx, canID.xlsx]
2018-02-23 add boards
    [button.brd, button.sch, motorController.brd, motorController.sch, optronik.PcbDoc, optronik.sch, panel.brd, panel.sch]
2018-03-05 Initial firmware commit
    Commit:
    1. Button firmware
    2. Panel firmware
    3. modify ignore rule
2018-04-09 motorControl update
    [canID.xlsx]
2018-04-10 update
    - motorControl update:
    > motorPan stop function update, but cant implement to motorTilt
    > when startup, motorTilt seem doesnt response to command
    - add optronik firmware initial commit, based on FCS's optronik firmware
2018-04-11 firmware & doc update
    - joystick data update
    - add trigger function
    - update optronik firmware
    [canID.xlsx]
2018-04-12 Update
    - add GY-80 IMU
2018-04-23 Revert "Update"
    This reverts commit fe09edef820f781b01c554e8742a3b63bd834693.
    [MotorControl.ino, Panel.ino, Tracker.cpp, Tracker.h, optronik.ino]
2018-04-23 add extBoard & update panel & motorControl board
    > update panel board
    > update motorControl board
    >add extBoard:
    - to replace mouse movement & left/right click
    - add clear target button
    - add manual lrf value manually using keypad and display it on 4 digits 7-segment
    [extBoard.sch, motorController.brd, motorController.sch, panel.brd, panel.sch]
2018-04-27 20180427 update
    Wiring:
    - update wiring diagram
    Optronik:
    - add IMU option (vectornav or custom IMU GY-80)
    Panel & MotorControl:
    - change "BUS_PANEL_x" to "BUS_MTR_CMD_x"
    [Wiring pinout.xlsx]
2018-04-27 20180427 update 2
    optronik:
    > all function ready
    Panel:
    > all function ready
    > need to find PID tuning for track movement & stab movement
